yuuahmad-aii/Shell-Eco-Marathon-Kukang-EV/PCB/SCH_SCH Shell Eco Marathon Behemoth_2026-08-27.pdf

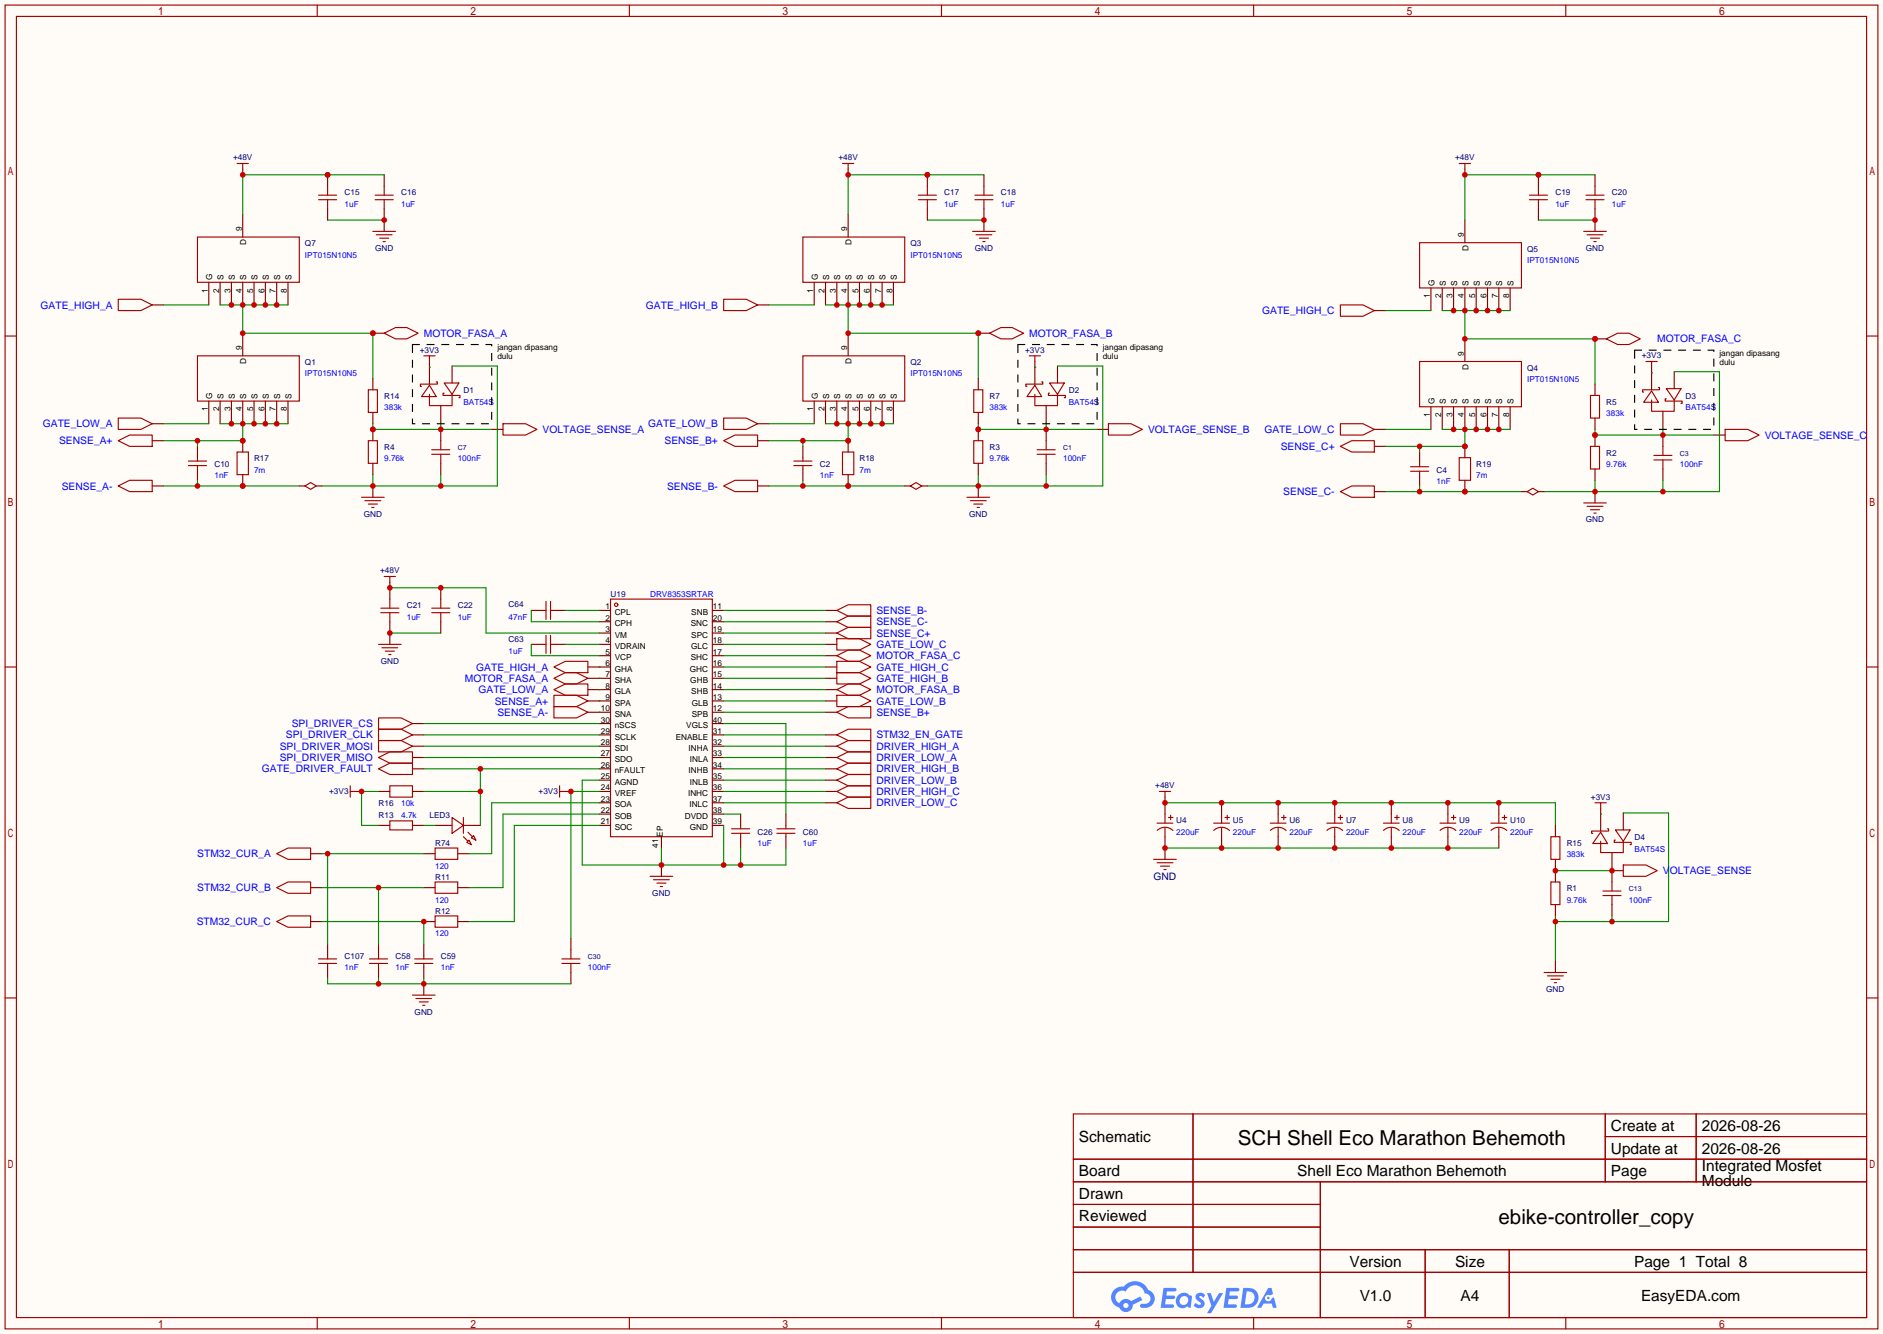
[picture p1: page 1]

Schematic | SCH Shell Eco Marathon Behemoth | Create at | 2026-08-26

Update at | 2026-08-26

Board | Shell Eco Marathon Behemoth | Page | Integrated Mosfet
Drawn | | ebike-controller_copy
Reviewed

Version | Size | Page 1 Total 8
V1.0 | A4 | EasyEDA.com

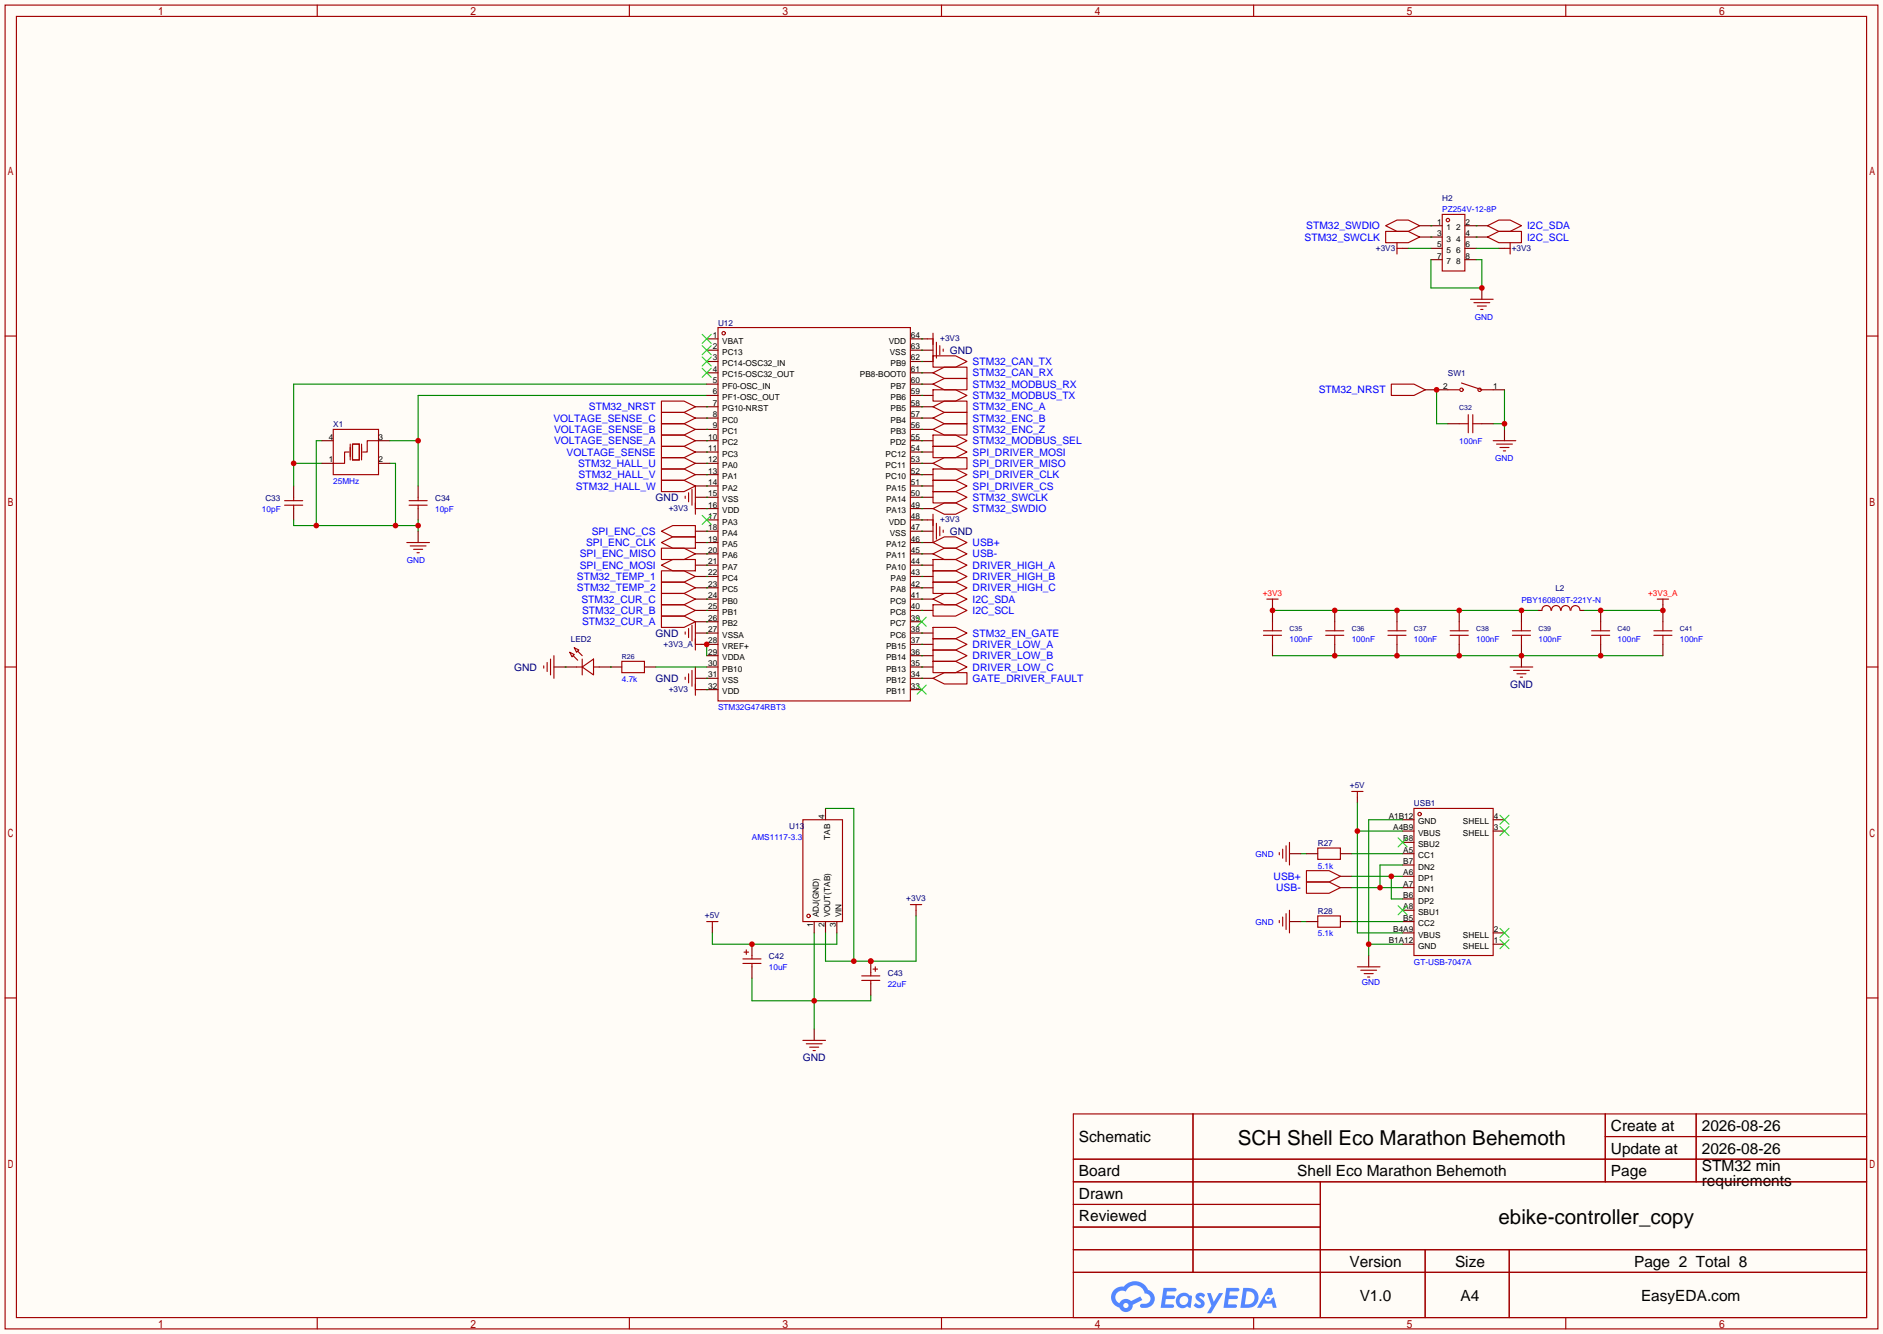
[picture p2: page 2]

GND B1A12 VBUS B4A9 CC2 B5 SBU1 A8 DP2 B6 DN1 A7 DP1 A6 DN2 B7 CC1 A5 SBU2 B8 VBUS A4B9 GND A1B12

Schematic | SCH Shell Eco Marathon Behemoth | Create at | 2026-08-26

Update at | 2026-08-26

Board | Shell Eco Marathon Behemoth | Page | STM32 min
Drawn | | ebike-controller_copy
Reviewed

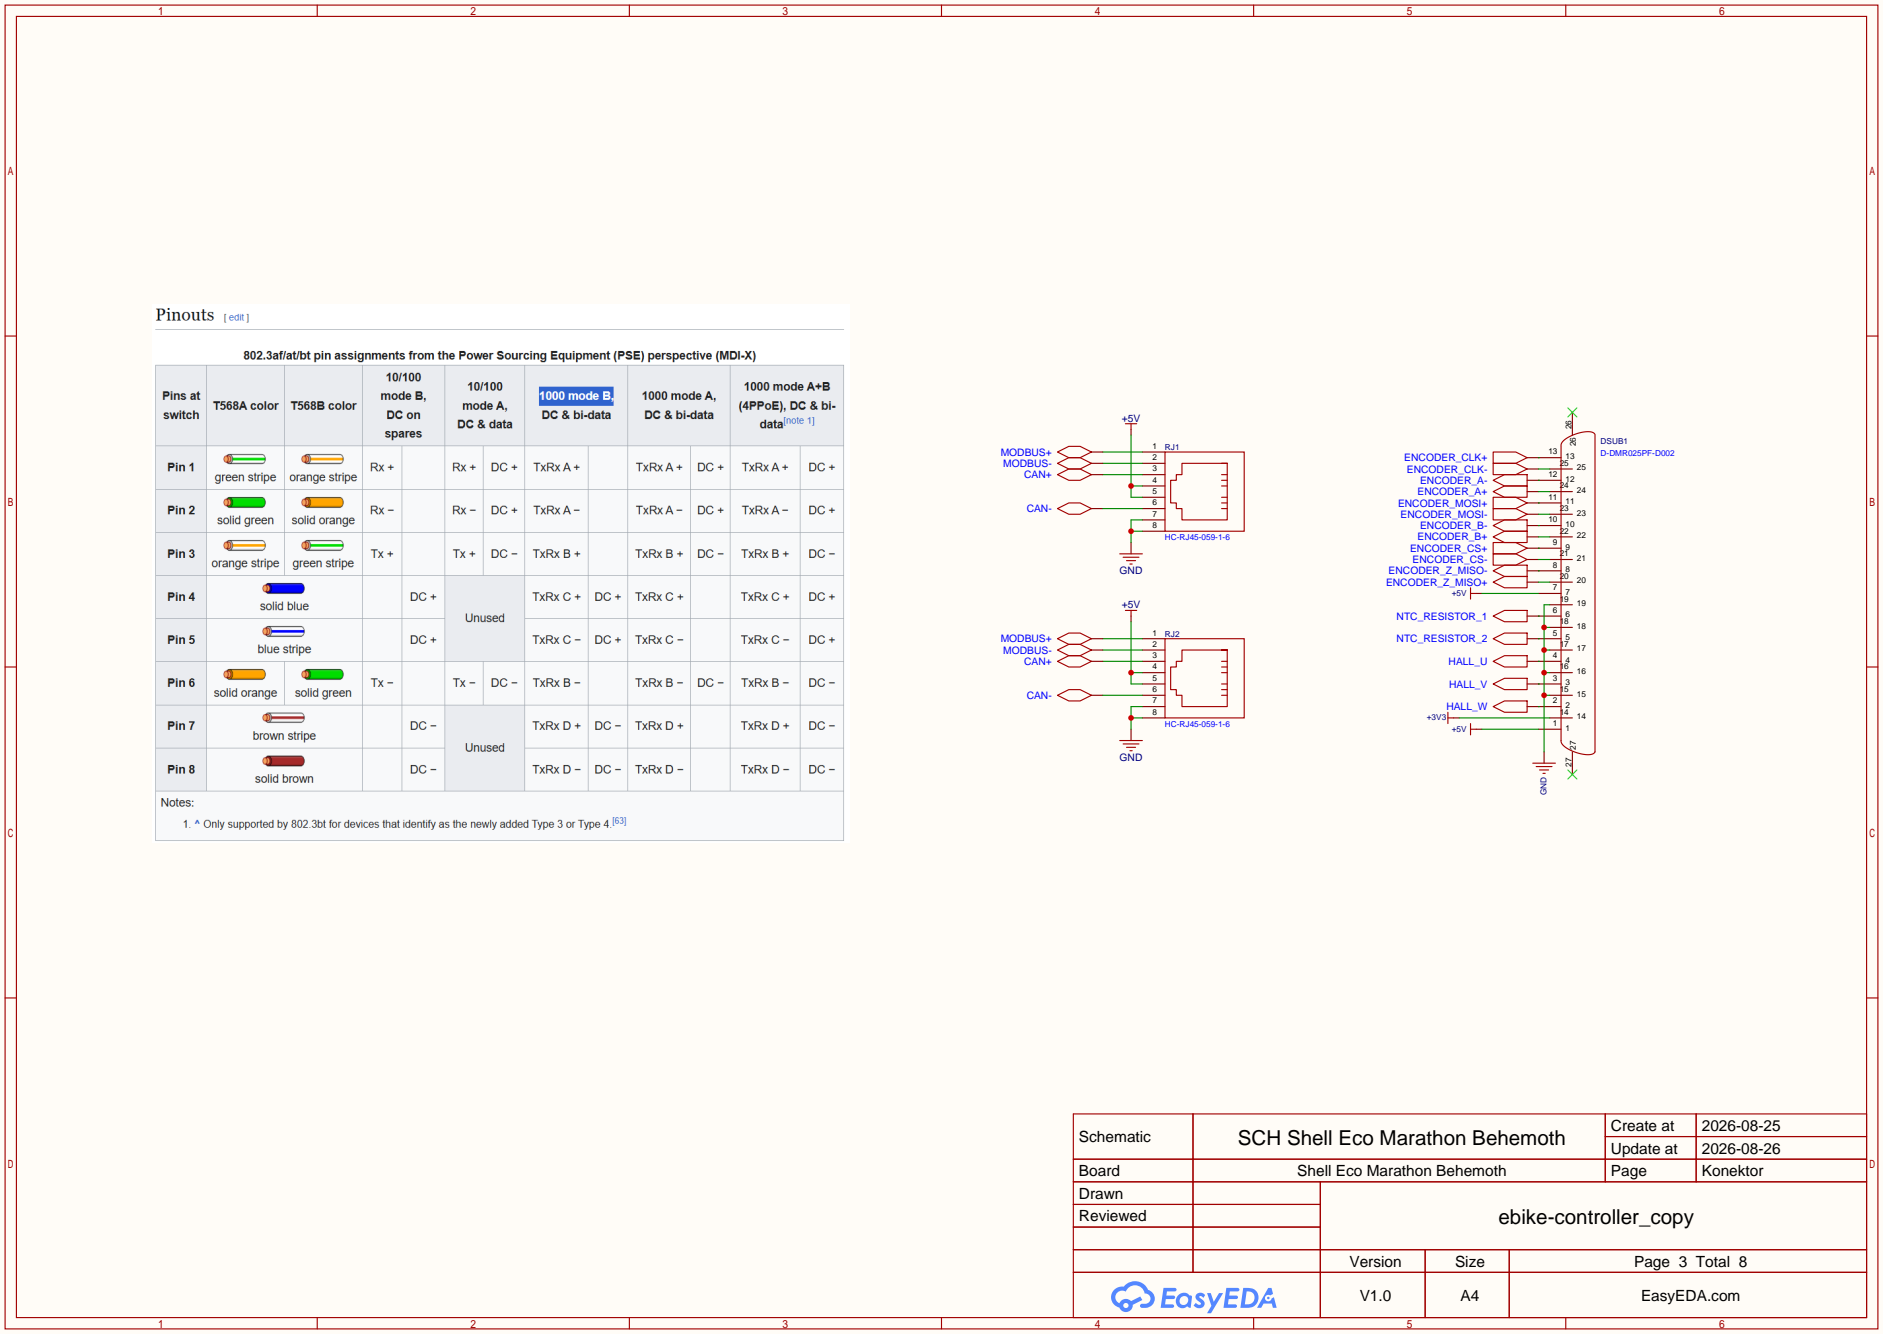
[picture p3: page 3]

Schematic | SCH Shell Eco Marathon Behemoth | Create at | 2026-08-25

Update at | 2026-08-26

Board | Shell Eco Marathon Behemoth | Page | Konektor
Drawn | | ebike-controller_copy
Reviewed

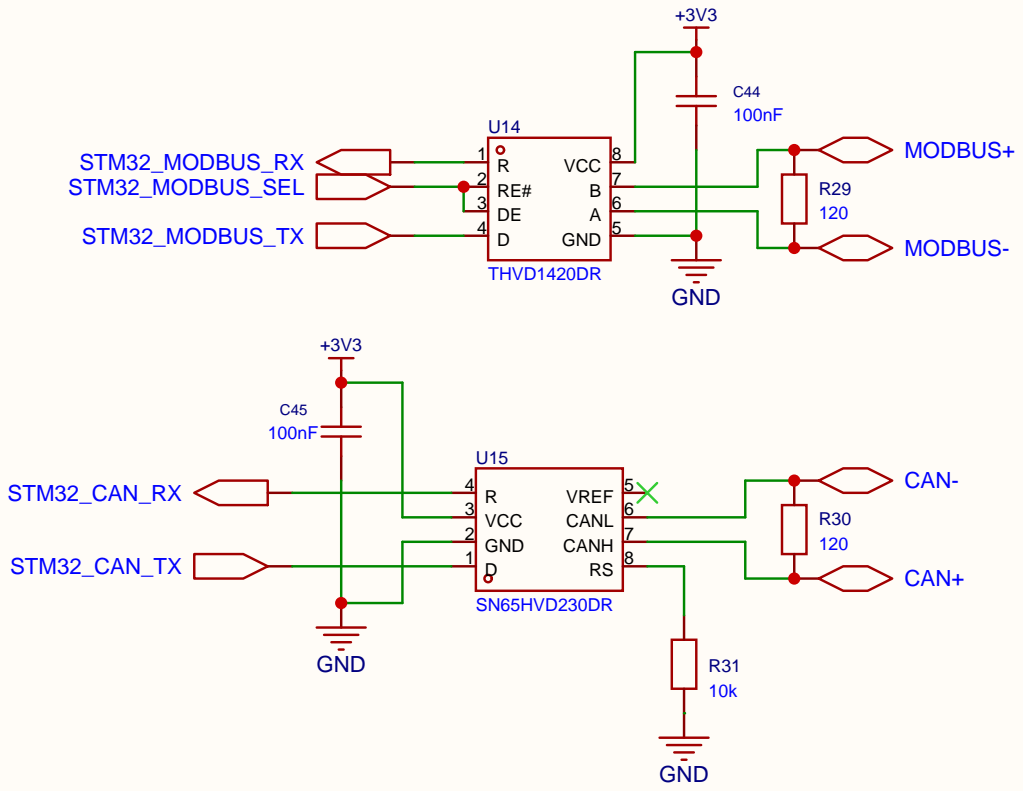
[picture p4: page 4]

Schematic | SCH Shell Eco Marathon Behemoth | Create at | 2026-08-25

Update at | 2026-08-25

Board | Shell Eco Marathon Behemoth | Page | Interface
Drawn | | ebike-controller_copy
Reviewed

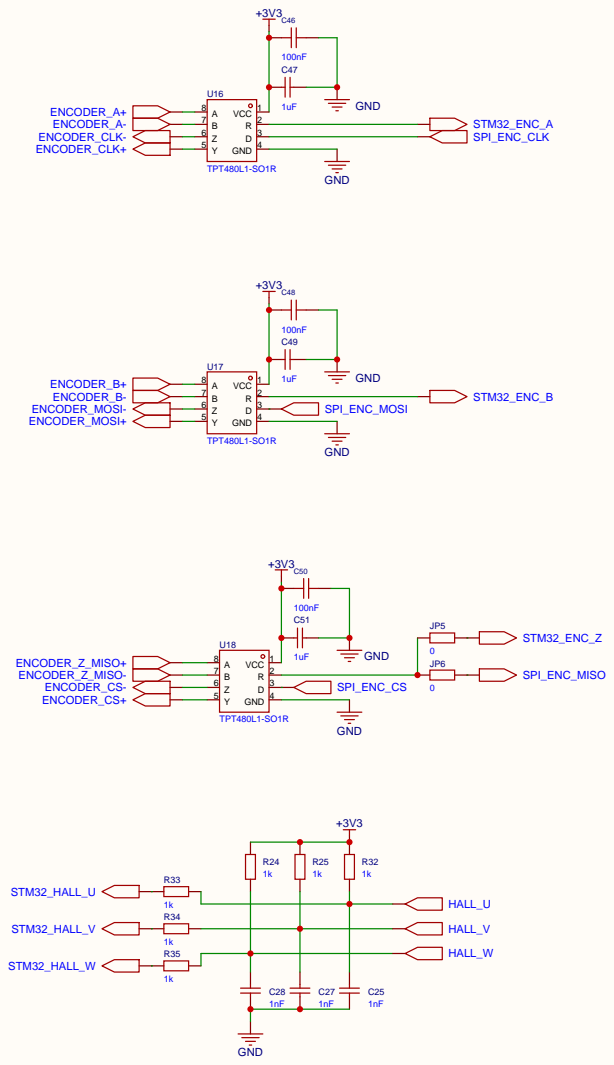
[picture p5: page 5]

Schematic | SCH Shell Eco Marathon Behemoth | Create at | 2026-08-25

Update at | 2026-08-26

Board | Shell Eco Marathon Behemoth | Page | Encoder interface
Drawn | | ebike-controller_copy
Reviewed

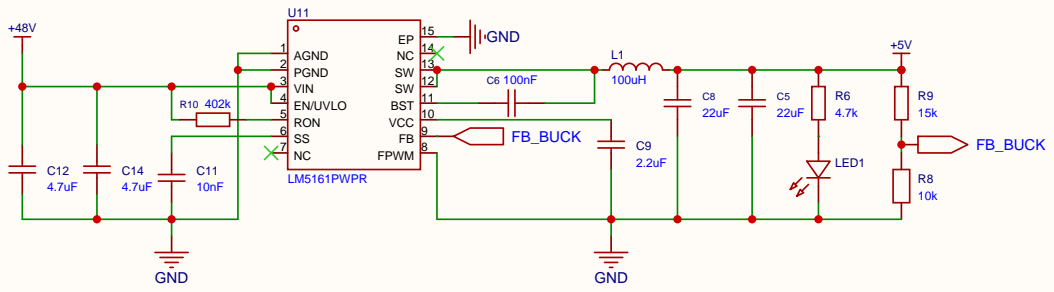
[picture p6: page 6]

VCC 10 BST 11 SW 12 SW 13 NC 14 EP 15

Schematic | SCH Shell Eco Marathon Behemoth | Create at | 2026-08-24

Update at | 2026-08-24

Board | Shell Eco Marathon Behemoth | Page | Power
Drawn | | ebike-controller_copy
Reviewed

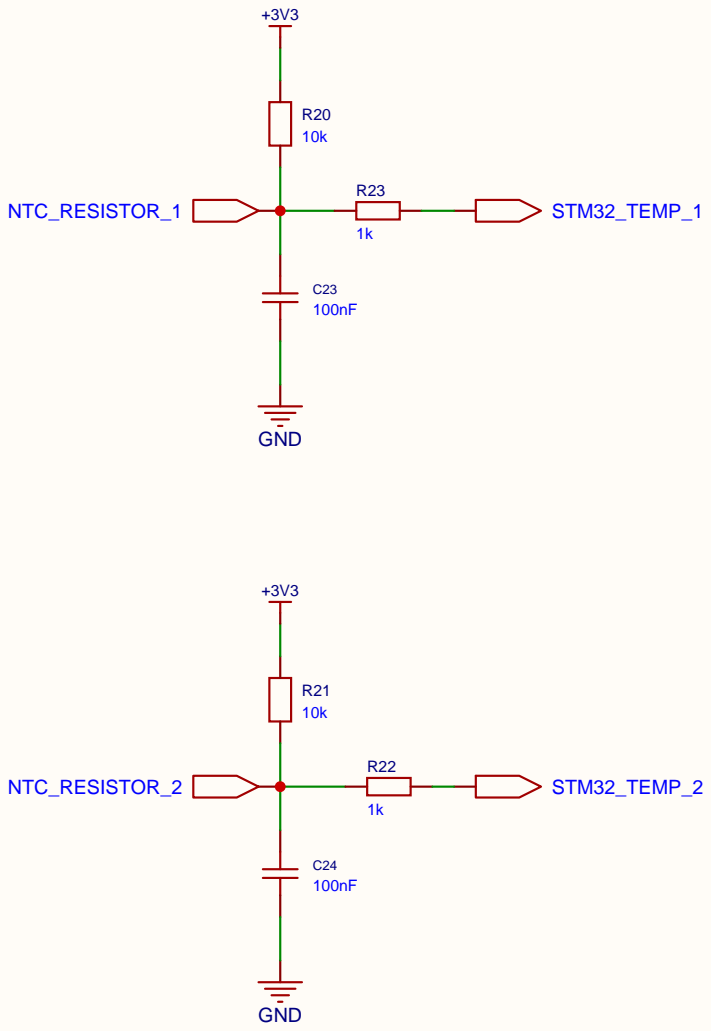
[picture p7: page 7]

Schematic | SCH Shell Eco Marathon Behemoth | Create at | 2026-08-25

Update at | 2026-08-26

Board | Shell Eco Marathon Behemoth | Page | Temp Sensor
Drawn | | ebike-controller_copy
Reviewed

Schematic | SCH Shell Eco Marathon Behemoth | Create at | 2026-08-24
| | Update at | 2026-08-24
Board | Shell Eco Marathon Behemoth | Page | Dokumentasi
Drawn | | ebike-controller_copy

# Reviewed

Version | Size | Page 8 Total 8

# General Specifications

# Microcontroller: STMicroelectronics STM32G474 (Math Accelerator, HRTIM, Triple-ADC)

# Gate Driver: Texas Instruments DRV8353SR (100V, Smart Gate Drive, SPI)

# Power Stage: Infineon IPT015N10N5 (100V, 1.5 m , TO-Leadless (TOLL))

# Logic Power Supply: Texas Instruments LM5161PWPR (100V Input, Fly-Buck Topology)

Control Algorithm: Field Oriented Control (FOC) dengan Regenerative Braking & Coast-and-Burn capability.

# Electrical Ratings

# Nominal DC Bus Voltage: 48V - 60V DC (Optimal for SEM)

# Absolute Maximum Voltage: 100V DC (Hardware destruction limit)

Overvoltage Protection (OVP) Trigger: Disarankan di-set pada 80V - 85V (melalui pembacaan VBUS di ADC STM32) untuk memutus PWM regen.

# Continuous Phase Current: 50A RMS

# Peak Phase Current: 120A (selama < 5 detik)

Switching Frequency: 20 kHz - 40 kHz (Dapat disesuaikan. Semakin tinggi frekuensi, switching loss naik namun current ripple turun).
