yuuahmad-aii/Shell-Eco-Marathon-Kukang-EV/STM32G431CBU6-kukang-hall-sensor-gate-driver/Core/Src/main.c

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
/* Includes ------------------------------------------------------------------*/
#include "main.h"
#include "usb_device.h"

/* USER CODE BEGIN Includes */
#include "config.h"
#include "current_sensor.h"
#include "six_step.h"

/* USER CODE END Includes */

ADC_HandleTypeDef hadc1;
ADC_HandleTypeDef hadc2;

CORDIC_HandleTypeDef hcordic;

FDCAN_HandleTypeDef hfdcan1;

FMAC_HandleTypeDef hfmac;

SPI_HandleTypeDef hspi1;

TIM_HandleTypeDef htim1;
TIM_HandleTypeDef htim2;

UART_HandleTypeDef huart1;

/* USER CODE BEGIN PV */
uint8_t usb_rx_buffer[64];
uint8_t usb_rx_index = 0;
uint8_t usb_cmd_ready = 0;
/* USER CODE END PV */

void SystemClock_Config(void);
static void MX_GPIO_Init(void);
static void MX_FDCAN1_Init(void);
static void MX_SPI1_Init(void);
static void MX_TIM1_Init(void);
static void MX_USART1_UART_Init(void);
static void MX_TIM2_Init(void);
static void MX_CORDIC_Init(void);
static void MX_FMAC_Init(void);
static void MX_ADC1_Init(void);
static void MX_ADC2_Init(void);
/* USER CODE BEGIN PFP */
void Process_USB_Receive(uint8_t *Buf, uint32_t Len);
void Parse_USB_Command(void);
/* USER CODE END PFP */

/* USER CODE BEGIN 0 */
FDCAN_RxHeaderTypeDef RxHeader;
uint8_t RxData[8];

volatile uint32_t last_can_cmd_tick = 0;
volatile uint8_t can_motor_active = 0;
volatile uint8_t can_cmd_pending = 0;
volatile uint8_t can_target_run_state = 0;
volatile uint16_t can_target_rpm = 0;

void Check_PB8_BOOT0_Config(void) {
  FLASH_OBProgramInitTypeDef OBInit;
  HAL_FLASHEx_OBGetConfig(&OBInit);

  // If BOOT0 is currently taken from PIN (FLASH_OPTR_nSWBOOT0 is set),
  // we must change it to OB_BOOT0_FROM_OB and ensure nBOOT0 = 1 so PB8 is freed
  // for CAN RX!
  if ((OBInit.USERConfig & FLASH_OPTR_nSWBOOT0) != 0) {
    HAL_FLASH_Unlock();
    HAL_FLASH_OB_Unlock();

    OBInit.OptionType = OPTIONBYTE_USER;
    OBInit.USERType = OB_USER_nSWBOOT0 | OB_USER_nBOOT0;
    OBInit.USERConfig = OB_BOOT0_FROM_OB | OB_nBOOT0_SET;

    if (HAL_FLASHEx_OBProgram(&OBInit) == HAL_OK) {
      HAL_FLASH_OB_Launch(); // Applies Option Bytes and resets MCU
    }
    HAL_FLASH_OB_Lock();
    HAL_FLASH_Lock();
  }
}

void HAL_FDCAN_RxFifo0Callback(FDCAN_HandleTypeDef *hfdcan,
                               uint32_t RxFifo0ITs) {
  if ((RxFifo0ITs & FDCAN_IT_RX_FIFO0_NEW_MESSAGE) != RESET) {
    if (HAL_FDCAN_GetRxMessage(hfdcan, FDCAN_RX_FIFO0, &RxHeader, RxData) ==
        HAL_OK) {
      if (RxHeader.Identifier == 0x10) {
        can_target_run_state = RxData[0];
        can_target_rpm = (uint16_t)(RxData[1] | (RxData[2] << 8));
        last_can_cmd_tick = HAL_GetTick();
        can_cmd_pending = 1;
      }
    }
  }
}

void Process_USB_Receive(uint8_t *Buf, uint32_t Len) {
  for (uint32_t i = 0; i < Len; i++) {
    if (usb_rx_index < sizeof(usb_rx_buffer) - 1) {
      usb_rx_buffer[usb_rx_index++] = Buf[i];
      if (Buf[i] == '\n' || Buf[i] == '\r') {
        usb_cmd_ready = 1;
      }
    } else {
      usb_rx_index = 0; // Overflow, reset
    }
  }
}

void Parse_USB_Command(void) {
  if (usb_cmd_ready) {
    for (int i = 0; i < usb_rx_index; i++) {
      if (usb_rx_buffer[i] == '\r' || usb_rx_buffer[i] == '\n') {
        usb_rx_buffer[i] = '\0';
        break;
      }
    }
    usb_rx_buffer[usb_rx_index] = '\0';

    Config_ParseCommand((char *)usb_rx_buffer);

    usb_rx_index = 0;
    usb_cmd_ready = 0;
  }
}
/* USER CODE END 0 */

/**
 * @brief  The application entry point.
 * @retval int
 */
int main(void) {

  /* MCU Configuration--------------------------------------------------------*/

  /* Reset of all peripherals, Initializes the Flash interface and the Systick.
   */
  HAL_Init();

  /* Configure the system clock */
  SystemClock_Config();

  /* Initialize all configured peripherals */
  MX_GPIO_Init();
  MX_FDCAN1_Init();
  MX_SPI1_Init();
  MX_TIM1_Init();
  MX_USART1_UART_Init();
  MX_USB_Device_Init();
  MX_TIM2_Init();
  MX_CORDIC_Init();
  MX_FMAC_Init();
  MX_ADC1_Init();
  MX_ADC2_Init();
  /* USER CODE BEGIN 2 */
  Check_PB8_BOOT0_Config();

  FDCAN_FilterTypeDef sFilterConfig;
  sFilterConfig.IdType = FDCAN_STANDARD_ID;
  sFilterConfig.FilterIndex = 0;
  sFilterConfig.FilterType = FDCAN_FILTER_MASK;
  sFilterConfig.FilterConfig = FDCAN_FILTER_TO_RXFIFO0;
  sFilterConfig.FilterID1 = 0x000;
  sFilterConfig.FilterID2 = 0x000;

  if (HAL_FDCAN_ConfigFilter(&hfdcan1, &sFilterConfig) != HAL_OK) {
    Error_Handler();
  }

  HAL_FDCAN_ConfigGlobalFilter(&hfdcan1, FDCAN_ACCEPT_IN_RX_FIFO0,
                               FDCAN_ACCEPT_IN_RX_FIFO0, FDCAN_FILTER_REMOTE,
                               FDCAN_FILTER_REMOTE);

  if (HAL_FDCAN_Start(&hfdcan1) != HAL_OK) {
    Error_Handler();
  }

  if (HAL_FDCAN_ActivateNotification(&hfdcan1, FDCAN_IT_RX_FIFO0_NEW_MESSAGE,
                                     0) != HAL_OK) {
    Error_Handler();
  }

  Config_Init();
  Config_ApplyPWMFrequency();
  SixStep_Init();
  CurrentSensor_Init();

  // Enable DWT Cycle Counter for timing
  CoreDebug->DEMCR |= CoreDebug_DEMCR_TRCENA_Msk;
  DWT->CYCCNT = 0;
  DWT->CTRL |= DWT_CTRL_CYCCNTENA_Msk;

  uint32_t last_verbose_time = HAL_GetTick();
  uint32_t last_can_status_tick = HAL_GetTick();
  uint32_t last_cycle_count = DWT->CYCCNT;
  /* USER CODE END 2 */

  /* Infinite loop */
  /* USER CODE BEGIN WHILE */
  while (1) {
    /* USER CODE END WHILE */

    /* USER CODE BEGIN 3 */
    uint32_t current_time = DWT->CYCCNT;
    uint32_t cycle_diff = current_time - last_cycle_count;

    // Limit control loop to ~20kHz to prevent float precision issues with very
    // small dt
    if (cycle_diff >= (SystemCoreClock / 20000)) {
      last_cycle_count = current_time;
      float dt = (float)cycle_diff / (float)SystemCoreClock;
      SixStep_Update(dt);
    }

    Parse_USB_Command();

    if (motor_config.verbose_output == 1) {
      if (HAL_GetTick() - last_verbose_time >= motor_config.verbose_period) {
        last_verbose_time = HAL_GetTick();
        SixStep_PrintVerbose();
      }
    }

    // Process pending CAN Motor Command in thread mode (so HAL_Delay in
    // SixStep_SetRPM works safely!)
    if (can_cmd_pending) {
      can_cmd_pending = 0;
      if (can_target_run_state == 1) {
        can_motor_active = 1;
        SixStep_SetRPM((float)can_target_rpm);
      } else {
        can_motor_active = 0;
        SixStep_Stop();
      }
    }

    // CAN Safety Watchdog: Auto-stop motor if throttle command packets stop
    // arriving for >350ms
    if (can_motor_active && (HAL_GetTick() - last_can_cmd_tick > 350)) {
      SixStep_Stop();
      can_motor_active = 0;
    }

    // Heartbeat & Status frame to Telemetry (CAN ID 0x20 every 100ms)
    if (HAL_GetTick() - last_can_status_tick >= 100) {
      last_can_status_tick = HAL_GetTick();

      // Bus-Off auto-recovery: clear CCCR.INIT if hardware entered bus-off
      if ((hfdcan1.Instance->PSR & FDCAN_PSR_BO) != 0) {
        CLEAR_BIT(hfdcan1.Instance->CCCR, FDCAN_CCCR_INIT);
      }

      FDCAN_TxHeaderTypeDef tx_hdr;
      uint8_t tx_data[8] = {0};

      tx_hdr.Identifier = 0x20;
      tx_hdr.IdType = FDCAN_STANDARD_ID;
      tx_hdr.TxFrameType = FDCAN_DATA_FRAME;
      tx_hdr.DataLength = FDCAN_DLC_BYTES_8;
      tx_hdr.ErrorStateIndicator = FDCAN_ESI_ACTIVE;
      tx_hdr.BitRateSwitch = FDCAN_BRS_OFF;
      tx_hdr.FDFormat = FDCAN_CLASSIC_CAN;
      tx_hdr.TxEventFifoControl = FDCAN_NO_TX_EVENTS;
      tx_hdr.MessageMarker = 0;

      extern float Get_DC_Bus_Voltage(void);
      extern float Get_Current_Iq(void);
      float vbus = Get_DC_Bus_Voltage();
      float actual_iq = Get_Current_Iq();

      uint16_t vbus_centi = (uint16_t)(vbus * 100.0f);
      int16_t iq_centi = (int16_t)(actual_iq * 100.0f);

      tx_data[0] = can_motor_active;
      tx_data[1] = (uint8_t)(vbus_centi & 0xFF);
      tx_data[2] = (uint8_t)((vbus_centi >> 8) & 0xFF);
      tx_data[3] = (uint8_t)(iq_centi & 0xFF);
      tx_data[4] = (uint8_t)((iq_centi >> 8) & 0xFF);
      tx_data[5] = 0;
      tx_data[6] = 0;
      tx_data[7] = 0;

      if (HAL_FDCAN_GetTxFifoFreeLevel(&hfdcan1) > 0) {
        HAL_FDCAN_AddMessageToTxFifoQ(&hfdcan1, &tx_hdr, tx_data);
      } else {
        HAL_FDCAN_AbortTxRequest(&hfdcan1, FDCAN_TX_BUFFER0 | FDCAN_TX_BUFFER1 |
                                               FDCAN_TX_BUFFER2);
      }
    }
  }
  /* USER CODE END 3 */
}

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
