yuuahmad-aii/Shell-Eco-Marathon-Kukang-EV/STM32F446RE-kukang-telemetry/Core/Inc/main.h

#define USER_BTN_Pin GPIO_PIN_13
#define USER_BTN_GPIO_Port GPIOC
#define SPI1_CS_BARO_Pin GPIO_PIN_4
#define SPI1_CS_BARO_GPIO_Port GPIOC
#define SPI1_CS_IMU_Pin GPIO_PIN_5
#define SPI1_CS_IMU_GPIO_Port GPIOC
#define USER_LED_Pin GPIO_PIN_2
#define USER_LED_GPIO_Port GPIOB
#define DS18B20_Pin GPIO_PIN_10
#define DS18B20_GPIO_Port GPIOB
#define SPI2_CS_Pin GPIO_PIN_12
#define SPI2_CS_GPIO_Port GPIOB
#define SDIO_DET_Pin GPIO_PIN_8
#define SDIO_DET_GPIO_Port GPIOA
