yuuahmad-aii/Shell-Eco-Marathon-Kukang-EV/STM32G431CBU6-kukang-hall-sensor-gate-driver/Core/Inc/six_step.h

#ifndef SIX_STEP_H
#define SIX_STEP_H

#include "stm32g4xx_hal.h"
#include <stdint.h>

// Initialize 6-step commutation variables
void SixStep_Init(void);

// Update the commutation based on Hall sensors. Call this in while(1) loop.
void SixStep_Update(float dt);

// Set speed (0.0 to 100.0)
void SixStep_SetRPM(float target_rpm);

// Stop the motor immediately (coast)
void SixStep_Stop(void);

// Print debug info
void SixStep_PrintVerbose(void);
void SixStep_PrintVerbose(void);
void SixStep_PrintDebug(void);

// FOC support
float SixStep_GetElectricalAngle(void);

// Hall Sensor helpers & Calibration
uint8_t SixStep_GetHallState(void);
void SixStep_CalibrateHall(float cal_voltage);

#endif // SIX_STEP_H
