yuuahmad-aii/Shell-Eco-Marathon-Kukang-EV/(commit log)

2026-08-29 update program dengan gate driver
2026-08-31 6step komutasi dengan hall sensor digital
2026-08-31 implementasi akselerasi sopan
    [motor_log_20260831_104354.csv, motor_log_20260831_105146.csv, motor_log_20260831_105625.csv, motor_log_20260831_111136.csv, motor_log_20260831_114304.csv, motor_log_20260831_115252.csv, motor_log_20260831_121025.csv, motor_log_20260831_131443.csv]
2026-09-04 buat gps menjadi automotive grade, tambah perintah usb cdc
    [log1.csv, log2.csv, log4.csv, log5.csv, log5_OLD.csv, log6.csv, log7.csv, log8.csv]
2026-09-06 implementasi webapp dan telemetri via firebase
    [KukangEV_Telemetry_2026-09-06T09-19-17-693Z.csv, KukangEV_Telemetry_2026-09-06T09-26-09-475Z.csv, log10.csv, log12.csv, log16.csv, log17.csv]
2026-09-06 hapus file yang tidak perlu, optimalisasi website
    [log29.csv, log30.csv]
2026-09-08 update fitur motor telemetry via web
    [motor_log_20260908_093130.csv, motor_log_20260908_093215.csv]
2026-09-08 merapikan web app, optimalisasi motor telemetry
2026-09-09 sensor voltase, ampere, temperature, update tampilan web
    [Motor_Telemetry_1788953880563.csv, sample_motor_telemetry.csv]
2026-09-10 implementasi timer hall sensor, fix bug motor terhentak
    [main.c, six_step.c]
2026-09-11 lengkapi variabel data logger, kalibrasi offset hall, fix bug logging microsd
    [Motor_Telemetry_jerk.csv, log79.csv, log80.csv, log81.csv]
2026-09-15 filter rpm, perbaiki tampilan mobile
    [Motor_Telemetry_1789438785404_jerk.csv, log1.csv, log10.csv, log12.csv, log16.csv, log17.csv, log2.csv, log29.csv]
2026-09-15 fix motor stuck dengan force next commutation dan deteksi stuck
    [six_step.c]
