yuuahmad-aii/Shell-Eco-Marathon-Kukang-EV/(notices)

Notices in the files:
STM32F446RE-kukang-telemetry/Core/Inc/main.h:
Copyright (c) 2026 STMicroelectronics.
All rights reserved.
This software is licensed under terms that can be found in the LICENSE file
